on7wp/Dice/README.md

# Dice
digitale dobbelsteen - digital dice - Attiny85 Lilypad

A small introductory project for very young starting programmers.
