on7wp/Dice/AT pinout.jpg

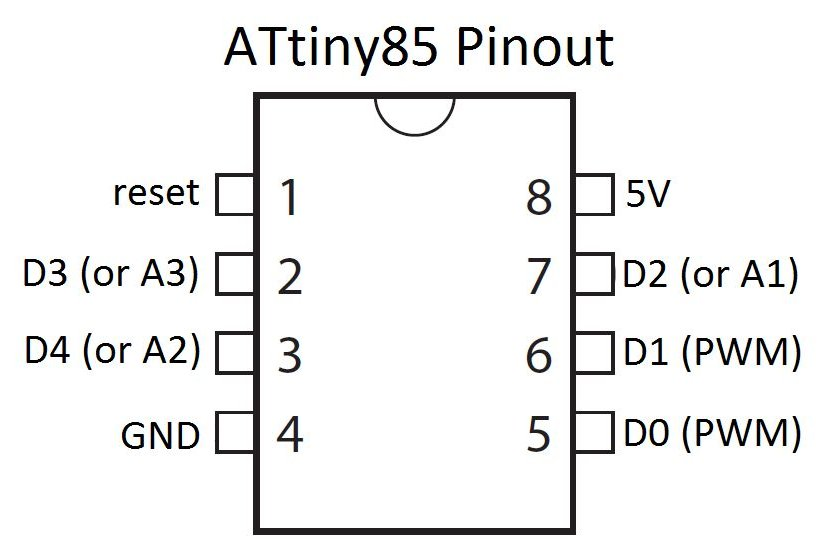
AT pinout.jpg
