on7wp/Dice/Circuit-Diagram-of-the-ATtiny85-USB-Mini-Development-Board.png

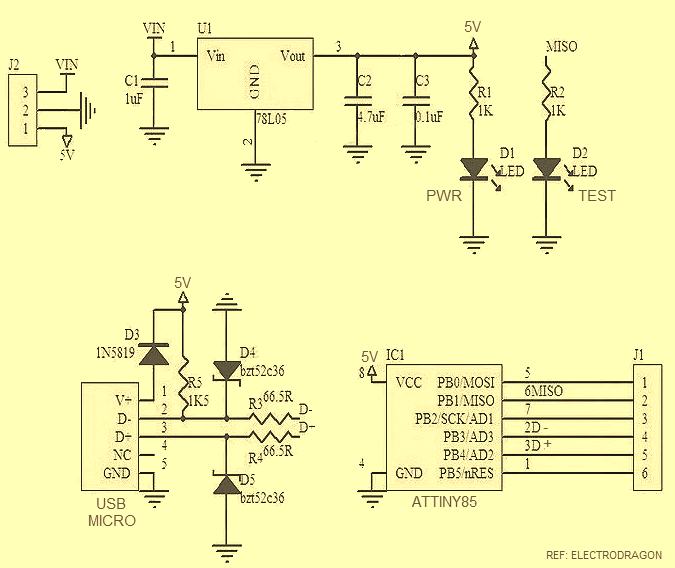
Circuit-Diagram-of-the-ATtiny85-USB-Mini-Development-Board.png
