on7wp/Dice/Pinout lily.jpg

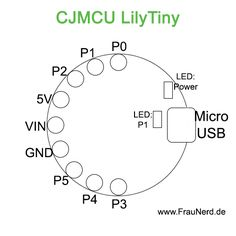
Pinout lily.jpg
